linjunway/Senior-Design-Project/ECE 445 · Senior Design Lab · ZJUI-UIUC · Team #50.1 · Junway Lin.pdf

E C E 4 4 5 · S e n i o r D e s i g n · Z J U I - U I U C · T e a m # 5 0 . 1 · J u n w a y L i n

# Automated Table Tennis Ball Sorter

4 classifications | 38mm & 40mm diameter | White & Orange colour | Custom PCB · 3D-printed · ATmega328P-PU

# THE PROBLEM

Since the 2000 ITTF regulation change, two incompatible standards coexist — 38mm celluloid (legacy) and 40mm ABS plastic (current). Visually indistinguishable to the naked eye, manual sorting introduces consistent classification errors and significant labour overhead in training and equipment management contexts.

# KEY PERFORMANCE TARGETS

100%

## A C C U R A C Y

≥ 92%

| A C C U R A C Y

≤ 5s

| | P E R B A L L

≤ 4

## M I N U T E S

≥ 98%

| | | J A M - F R E E

< 10ms

| | | L A T E N C Y

# SORTING SEQUENCE — HOW IT WORKS

01

# Load hopper

›

02

# Archimedes screw

›

03

# Tapered roller

›

04

# Colour sensor

05
06

# Diverter

# SUBSYSTEM BREAKDOWN

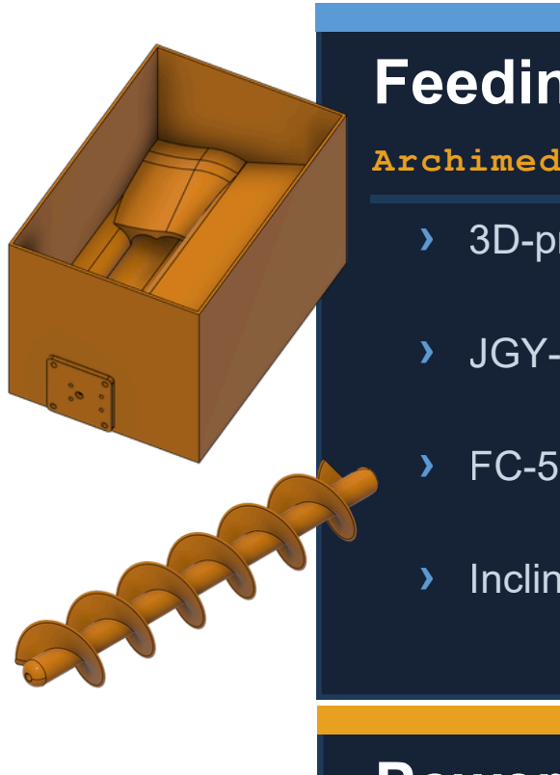
[picture p43: figure]

## Feeding System

Archimedes screw | · | IR sensor
› 3D-printed PLA screw — 42mm flight spacing, 200mm length › JGY-370 12V DC gear motor — 30–60 RPM, ≥ 5 kg·cm torque › FC-51 IR sensor — detects empty hopper, stops motor automatically › Inclined hopper base eliminates dead zones; all balls self-feed to screw inlet

## Sorting System

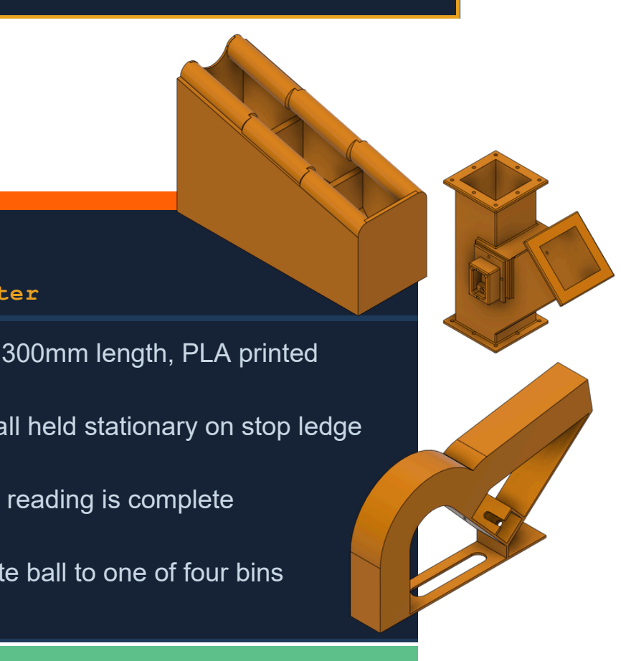
[picture p44: figure]

Tapered roller | · | colour station | · | diverter
› Tapered rollers — passive 37→38.5→40.5mm gap, 300mm length, PLA printed › TCS34725 colour sensor in sealed dark chamber; ball held stationary on stop ledge › 12V solenoid (10–15mm stroke) lifts ball after colour reading is complete › MG90S servo drives single-blade diverter 60° to route ball to one of four bins

## Power System

12V input | · | LM2596 buck converter | · | 5V logic rail

› 12V 3A wall adapter → LM2596 buck converter → 5V rail for MCU, sensors, servos › Isolated power paths — high-current (motor, solenoids) separated from logic rail › 2A slow-blow fuse + 1N4007 reverse polarity protection diode on main input › Resettable fuse (TLC-MSMD200) on motor path for overcurrent protection

## Control System

Custom KiCAD PCB | · | ATmega328P
› ATmega328P-PU on custom KiCAD PCB — Arduino-bootloaded, 16 MHz crystal › TB6612FNG H-bridge for DC motor · IRLZ44N MOSFETs for solenoid switching › TCA9548A I²C multiplexer addresses both TCS34725 colour sensors independently › State machine: IDLE → FEEDING → DETECTING → DIVERTING → DONE

# KEY ENGINEERING DECISIONS

## Mechanical vs sensor-based sizing

# Tapered rollers over sensor-based diameter detection

## Stationary vs in-motion reading

# Stop-ledge colour detection over inline sensing

## T O T A L B O M C O S T

# ~289 RMB

## Diameter sorting (38 vs 40mm)

## Colour detection (white vs orange)

## Full cycle: feed → detect → divert

## Full 40-ball batch runtime

## 40-ball continuous operation

## IR trigger → solenoid actuation

## Up to 80 or more mixed balls dropped in

## Feeds one ball at a time, approx. 20 per min (depends on motor RPM)

## 37→38.5→40.5mm gap: passive diameter sort

TCS34725 in dark chamber,

## ball stationary

## Pushes the ball upward from the stop-ledge

## Servo blade routes ball to correct bin

## Passive mechanical sorting requires zero calibration, zero electronics, and produces no false positives from sensor noise or lighting variation. The gap geometry itself is the classifier — no

software logic required.

The TCS34725 is highly sensitive to motion and ambient light.

## Holding the ball stationary on a stop ledge inside a sealed dark chamber before reading eliminates both error sources, reliably

achieving the ≥90% accuracy target.
