linjunway/Senior-Design-Project/3D_models/Square_Pipe.step

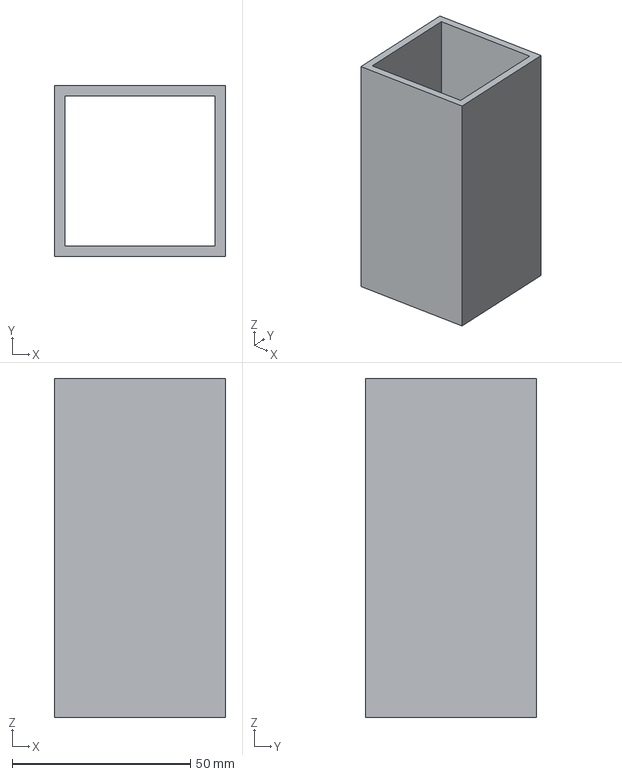
[picture p45: CAD file, 2026-06-12]
3D_models/Square_Pipe.step
48.0 x 48.0 x 95.0 mm
