linjunway/Senior-Design-Project/3D_models/乒乓小球/打印/挡板箱体.stp

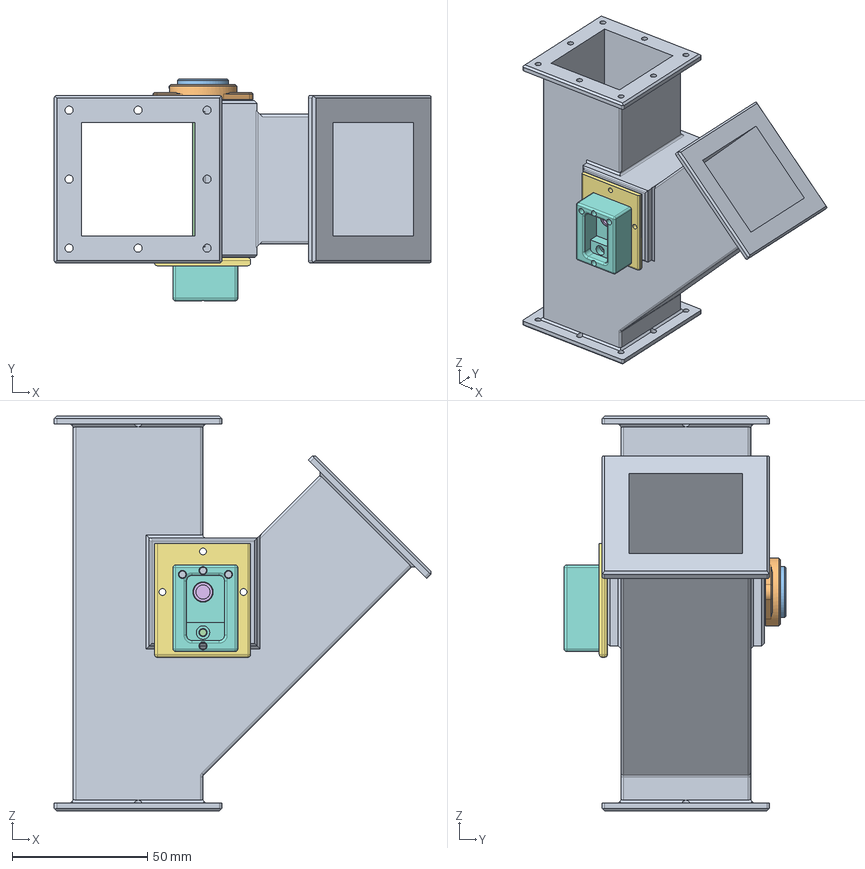
[picture p46: CAD file, 2026-06-12]
3D_models/乒乓小球/打印/挡板箱体.stp
139.2 x 82.0 x 146.0 mm
