linjunway/Senior-Design-Project/3D_models/TaperedRectangle.step

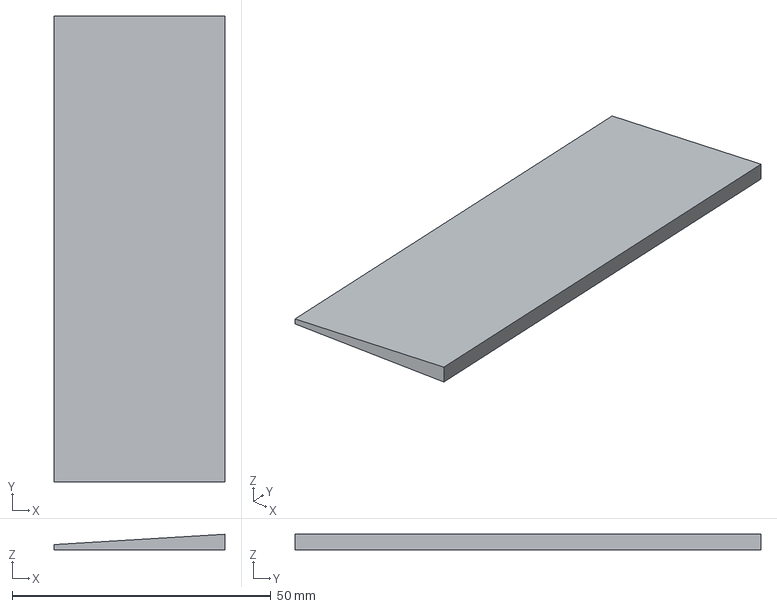
[picture p47: CAD file, 2026-06-12]
3D_models/TaperedRectangle.step
33.0 x 90.0 x 3.00 mm
