linjunway/Senior-Design-Project/3D_models/乒乓小球/打印/筛选.stp

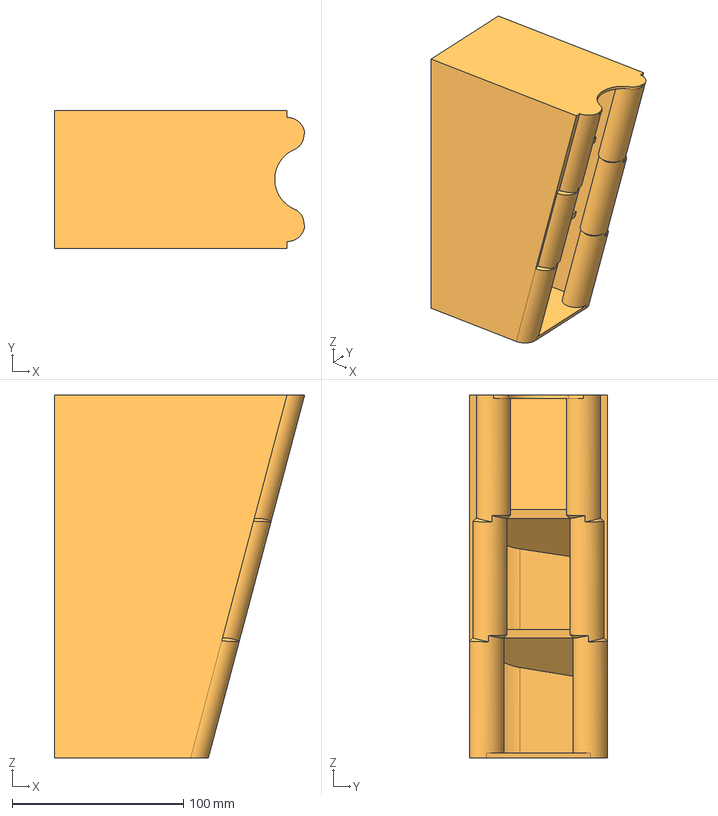
[picture p48: CAD file, 2026-06-12]
3D_models/乒乓小球/打印/筛选.stp
146.3 x 80.5 x 212.0 mm
