linjunway/Senior-Design-Project/3D_models/sensor_stand.step

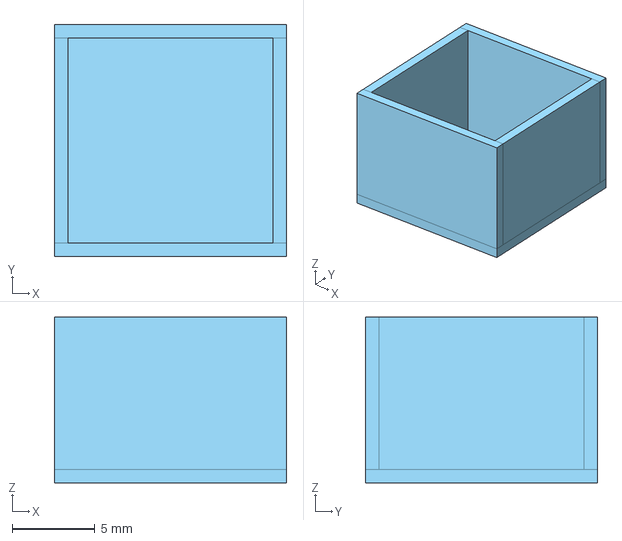
[picture p49: CAD file, 2026-06-12]
3D_models/sensor_stand.step
14.0 x 14.0 x 10.0 mm
