linjunway/Senior-Design-Project/3D_models/乒乓小球/打印/螺杆改.stp

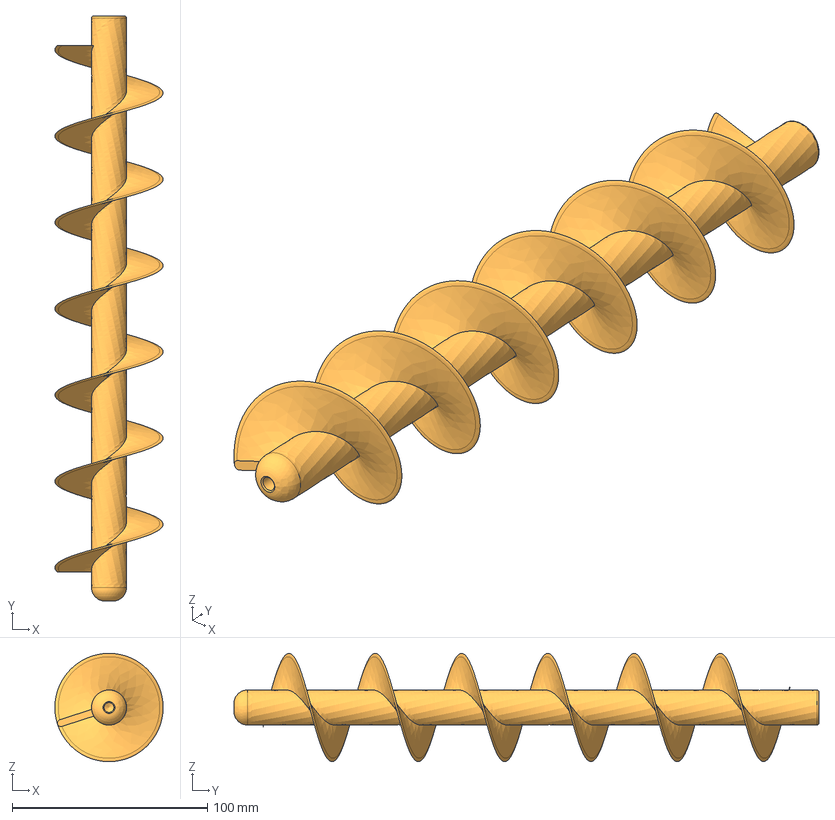
[picture p50: CAD file, 2026-06-12]
3D_models/乒乓小球/打印/螺杆改.stp
55.5 x 299.9 x 55.5 mm
