linjunway/Senior-Design-Project/3D_models/42mm_90deg_Elbow.step

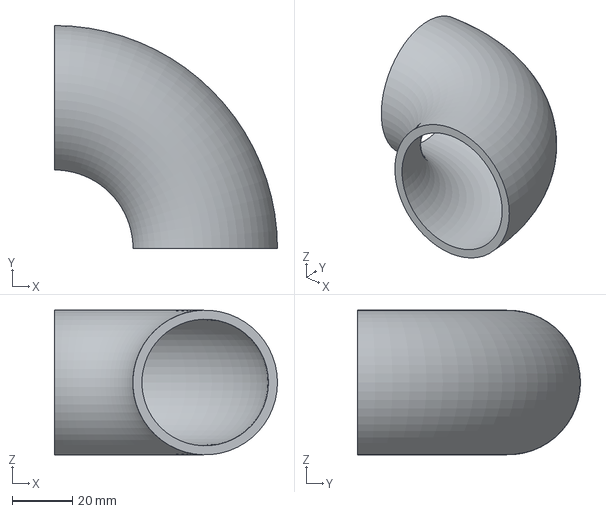
[picture p51: CAD file, 2026-06-12]
3D_models/42mm_90deg_Elbow.step
74.0 x 74.0 x 48.0 mm
