linjunway/Senior-Design-Project/3D_models/乒乓小球/打印/螺杆.stp

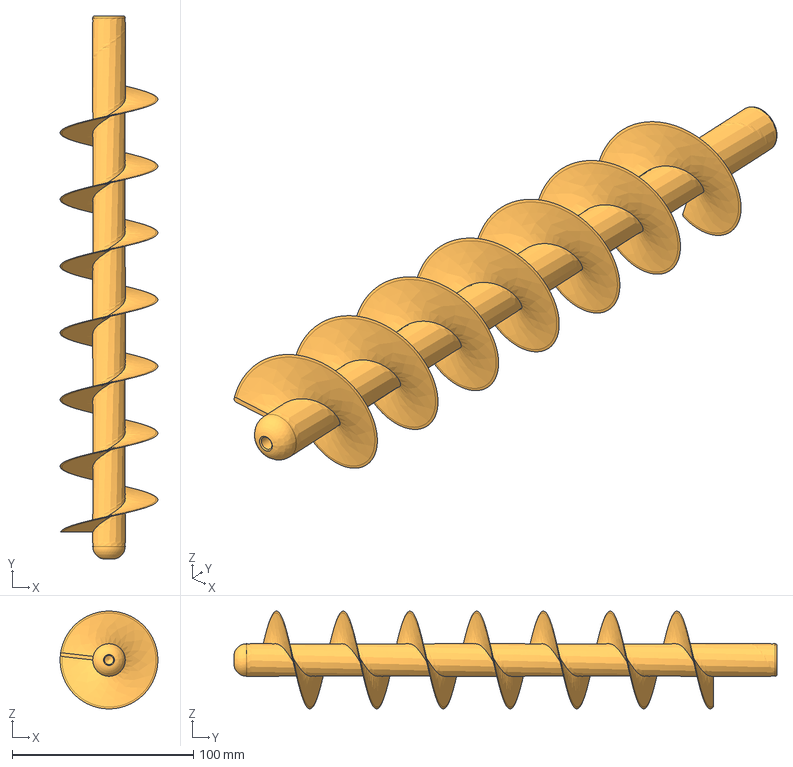
[picture p52: CAD file, 2026-06-12]
3D_models/乒乓小球/打印/螺杆.stp
54.0 x 299.9 x 54.0 mm
