linjunway/Senior-Design-Project/3D_models/Sloped_Open_Frame.step

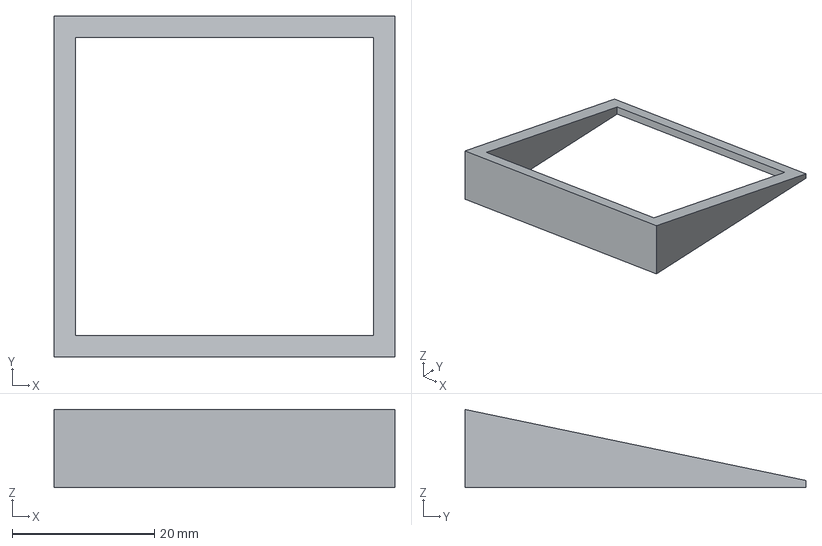
[picture p53: CAD file, 2026-06-12]
3D_models/Sloped_Open_Frame.step
48.0 x 48.0 x 11.0 mm
