linjunway/Senior-Design-Project/3D_models/乒乓小球/打印/箱体一.stp

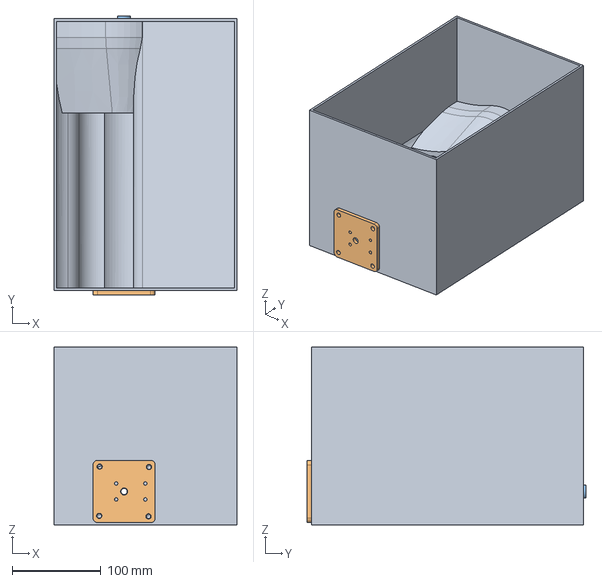
[picture p54: CAD file, 2026-06-12]
3D_models/乒乓小球/打印/箱体一.stp
206.0 x 314.0 x 200.0 mm
