linjunway/Senior-Design-Project/3D_models/Slope.step

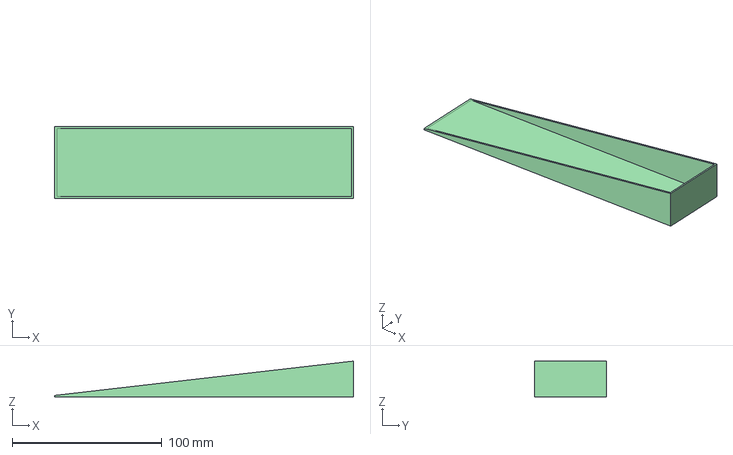
[picture p55: CAD file, 2026-06-12]
3D_models/Slope.step
200.0 x 48.0 x 24.0 mm
