linjunway/Senior-Design-Project/3D_models/乒乓小球/打印/通道.stp

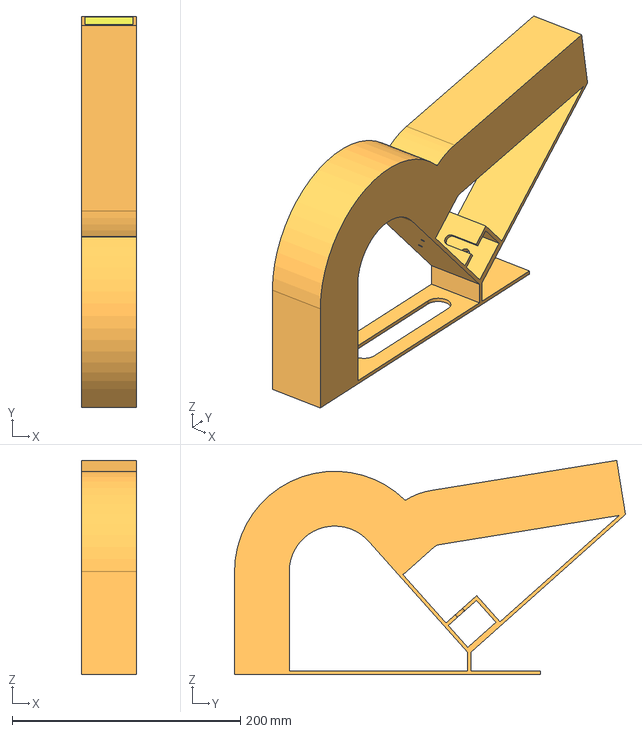
[picture p56: CAD file, 2026-06-12]
3D_models/乒乓小球/打印/通道.stp
48.0 x 342.7 x 187.8 mm
