linjunway/Senior-Design-Project/(list of files, cad)

Other CAD files:
3D_models/乒乓小球/体2.prt
3D_models/乒乓小球/筛选.prt
3D_models/乒乓小球/箱体1.prt
3D_models/乒乓小球/螺杆.prt
3D_models/乒乓小球/通道.prt
