linjunway/Senior-Design-Project/PCB/controller_group52.kicad_pcb

## KiCad design PCB/controller_group52.kicad_pcb (2026-06-12)

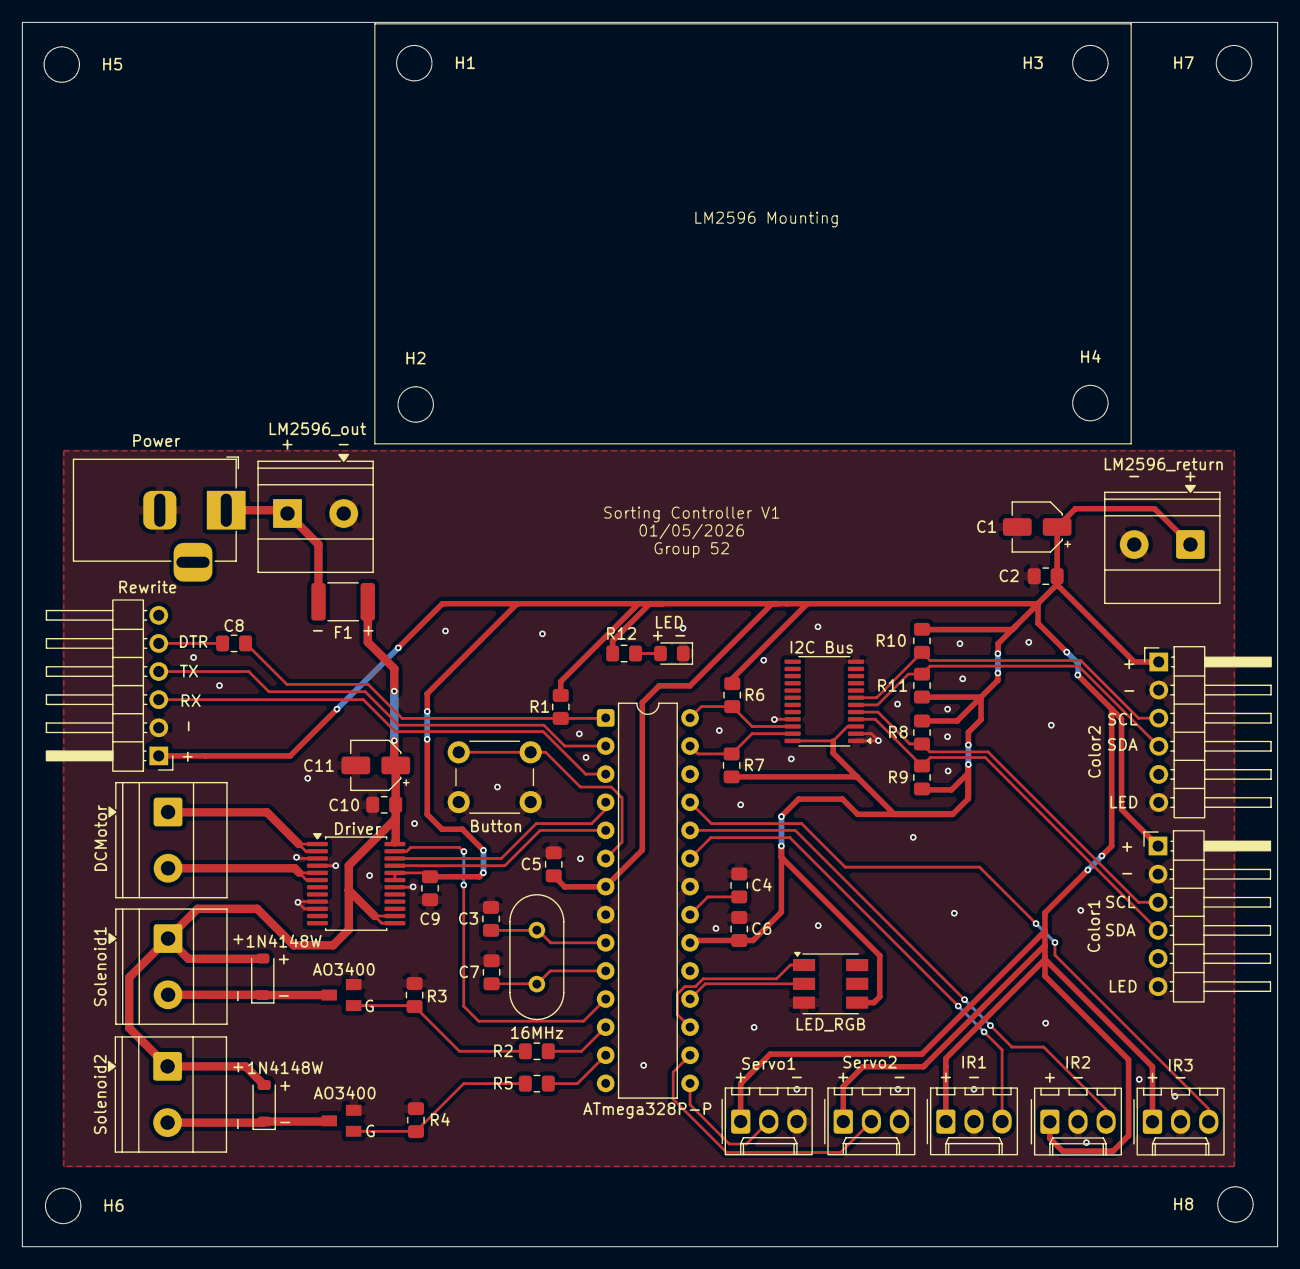
[picture p57: board controller_group52.kicad_pcb from above]

Board: 2 copper layers, 113.4 x 110.6 mm, 57 parts (0 on the bottom side), 37 nets.

Parts:
C1, C11: 10uF; CP_Elec_4x5.4
C2: 1uF; C_0805_2012Metric_Pad1.18x1.45mm_HandSolder
C3, C7: 22pF; C_0805_2012Metric_Pad1.18x1.45mm_HandSolder
C4, C5, C6, C8, C9, C10: 0.1uF; C_0805_2012Metric_Pad1.18x1.45mm_HandSolder
D1, D2: 1N4148W; D_SOD-123
D3: LED_RGB; LED_RGB_5050-6
D4: LED; LED_0805_2012Metric_Pad1.15x1.40mm_HandSolder
F1: 2A12V; Fuse_1812_4532Metric_Pad1.30x3.40mm_HandSolder
H1, H2, H3, H4, H5, H6, H7, H8: MountingHole; MountingHole_3.2mm_M3
J1: IR1; Molex_KK-254_AE-6410-03A_1x03_P2.54mm_Vertical
J2: Power; BarrelJack_Horizontal
J3: Rewrite; PinHeader_1x06_P2.54mm_Horizontal
J4: Servo1; Molex_KK-254_AE-6410-03A_1x03_P2.54mm_Vertical
J5: Servo2; Molex_KK-254_AE-6410-03A_1x03_P2.54mm_Vertical
J6: DCMotor; TerminalBlock_Phoenix_MKDS-1,5-2-5.08_1x02_P5.08mm_Horizont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
J7: Solenoid1; TerminalBlock_Phoenix_MKDS-1,5-2-5.08_1x02_P5.08mm_Horizont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
J8: Solenoid2; TerminalBlock_Phoenix_MKDS-1,5-2-5.08_1x02_P5.08mm_Horizont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
J9: LM2596_out; TerminalBlock_Phoenix_MKDS-1,5-2-5.08_1x02_P5.08mm_Horizont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
J10: LM2596_return; TerminalBlock_Phoenix_MKDS-1,5-2-5.08_1x02_P5.08mm_Horizont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
J11: IR2; Molex_KK-254_AE-6410-03A_1x03_P2.54mm_Vertical
J12: IR3; Molex_KK-254_AE-6410-03A_1x03_P2.54mm_Vertical
R1: 10K; C_0805_2012Metric_Pad1.18x1.45mm_HandSolder
R2, R5, R12: 220; C_0805_2012Metric_Pad1.18x1.45mm_HandSolder
R3, R4, R6, R7, R8, R9, R10, R11: 10k; C_0805_2012Metric_Pad1.18x1.45mm_HandSolder
SW1: Button; SW_PUSH_6mm_H9.5mm
U1: ATmega328P-P; DIP-28_W7.62mm
U2: Driver; SSOP-24_5.3x8.2mm_P0.65mm
U3, U4: AO3400; SOT23
U5: I2C Bus; TSSOP-24_4.4x7.8mm_P0.65mm
U6: Color1; PinHeader_1x06_P2.54mm_Horizontal
U7: Color2; PinHeader_1x06_P2.54mm_Horizontal
Y1: 16MHz; Crystal_HC49-4H_Vertical

Connections:
+5V: C1.1, C2.2, C5.2, C6.1, C9.2, D3.4 (VCC), J1.1, J3.1, J4.1, J5.1, J10.1, J11.1, J12.1, R1.2, R6.2, R7.2, R8.2, R9.2, R10.2, R11.2, R12.2, U1.7 (VCC), U1.20 (AVCC), U2.19 (STBY), U2.20 (VCC), U5.3 (~RESET), U5.24 (VCC), U6.1 (VIN), U7.1 (VIN)
+12V: C10.2, C11.1, D1.2 (A), D2.2 (A), F1.2, J7.1, J8.1, U2.13 (VM2), U2.14 (VM3), U2.24 (VM1)
/A01: J6.1, U2.1 (AO1), U2.2 (AO1)
/A02: J6.2, U2.5 (AO2), U2.6 (AO2)
/AIN1: U1.5 (PD3), U2.21 (AIN1)
/AIN2: U1.4 (PD2), U2.22 (AIN2)
/Button: SW1.1, U1.6 (PD4)
/CI: D3.2 (CI), U1.18 (PB4)
/DI: D3.1 (DI), U1.17 (PB3)
/DTR: C8.2, R1.1, U1.1 (~RESET/PC6)
/PB1: J4.2, U1.15 (PB1)
/PB2: J5.2, U1.16 (PB2)
/PC0: J1.3, U1.23 (PC0)
/PC1: J11.3, U1.24 (PC1)
/PC2: J12.3, U1.25 (PC2)
/PD6: R2.2, R3.1, U4.1
/PD7: R4.1, R5.1, U3.1
/PWM: U1.11 (PD5), U2.23 (PWMA)
/RX: J3.3, U1.3 (PD1)
/SC0: R8.1, U5.5 (SC0), U6.3 (SCL)
/SC1: R10.1, U5.7 (SC1), U7.3 (SCL)
/SCL: R6.1, U1.28 (PC5), U5.22 (SCL)
/SD0: R9.1, U5.4 (SD0), U6.4 (SDA)
/SD1: R11.1, U5.6 (SD1), U7.4 (SDA)
/SDA: R7.1, U1.27 (PC4), U5.23 (SDA)
/TX: J3.4, U1.2 (PD0)
GND: C1.2, C2.1, C3.2, C4.2, C5.1, C6.2, C7.2, C9.1, C10.1, C11.2, D3.3 (GND), D4.1 (K), J1.2, J2.2, J3.2, J4.3, J5.3, J9.1, J10.2, J11.2, J12.2, R3.2, R4.2, SW1.2, U1.8 (GND), U1.22 (GND), U2.3 (PGND1), U2.4 (PGND1), U2.9 (PGND2), U2.10 (PGND2), U2.18 (GND), U3.2, U4.2, U5.1 (A0), U5.2 (A1), U5.12 (GND), U5.21 (A2), U6.2 (GND), U6.6 (LED), U7.2 (GND), U7.6 (LED)
unnamed: D1.1 (K), J8.2, U3.3
unnamed: D2.1 (K), J7.2, U4.3
unnamed: D4.2 (A), R12.1
unnamed: C8.1, J3.5
unnamed: F1.1, J2.1, J9.2
unnamed: C4.1, U1.21 (AREF)
unnamed: R2.1, U1.12 (PD6)
unnamed: R5.2, U1.13 (PD7)
unnamed: C3.1, U1.9 (XTAL1/PB6), Y1.2
unnamed: C7.1, U1.10 (XTAL2/PB7), Y1.1
